3XAY/smartlamp/Documentation Pictures/PXL_20260616_120528385.jpg

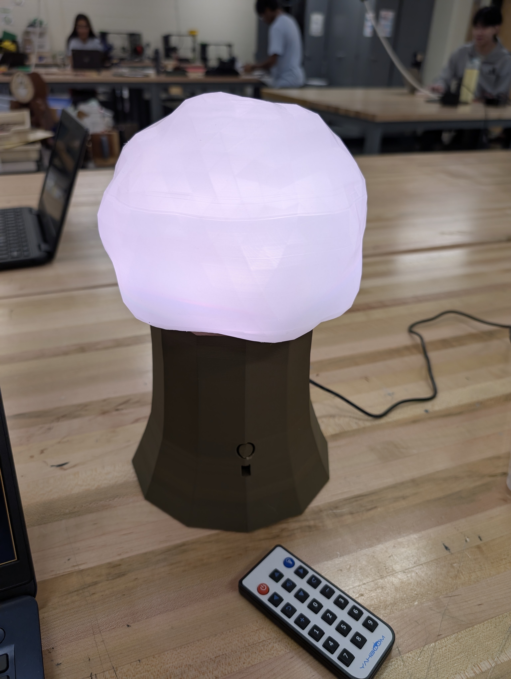
Documentation Pictures/PXL_20260616_120528385.jpg
