3XAY/smartlamp/Documentation Pictures/PXL_20260608_141349632.jpg

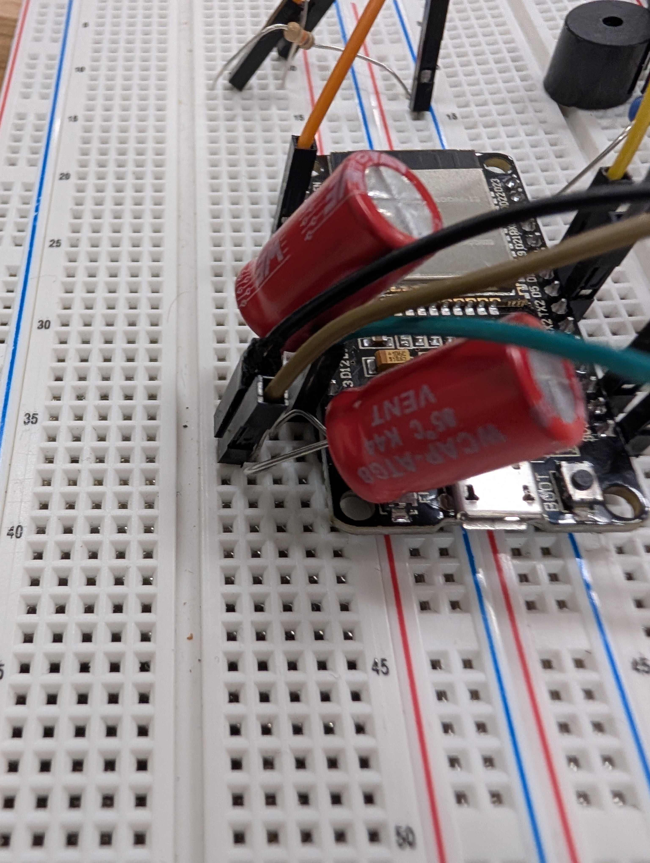
Documentation Pictures/PXL_20260608_141349632.jpg
