3XAY/smartlamp/Lamp Portfolio.pdf

# Lamp Portfolio

## Ayan Bindal

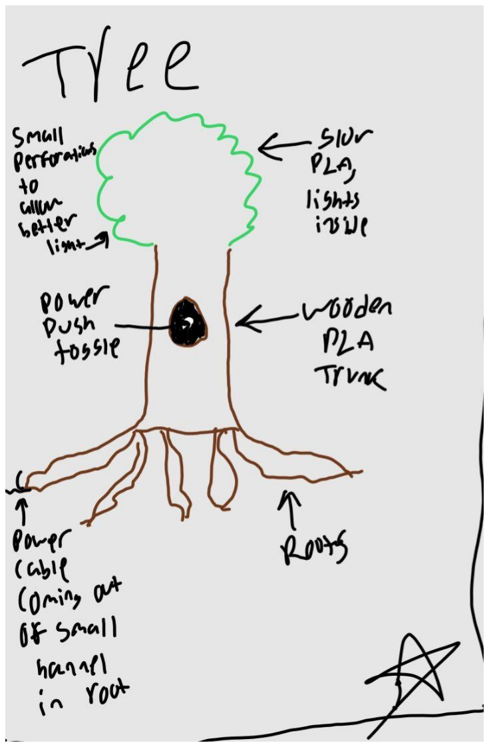
[picture p3: figure]

## Idea #1 - Tree

## Idea #2 - Mushroom

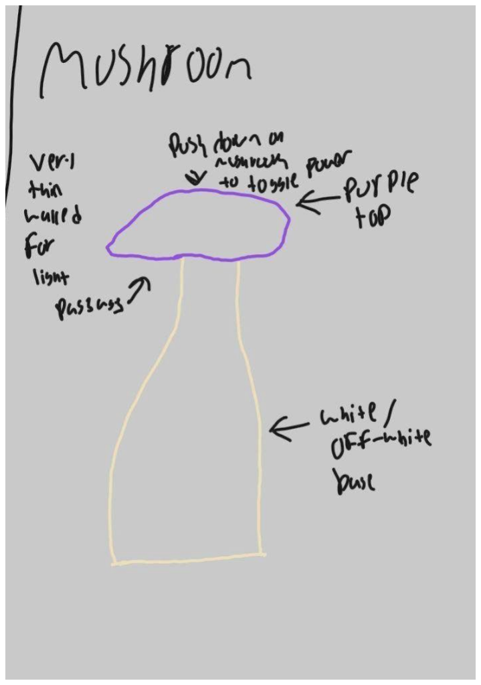
[picture p4: figure]

## Idea #3 - Abstract

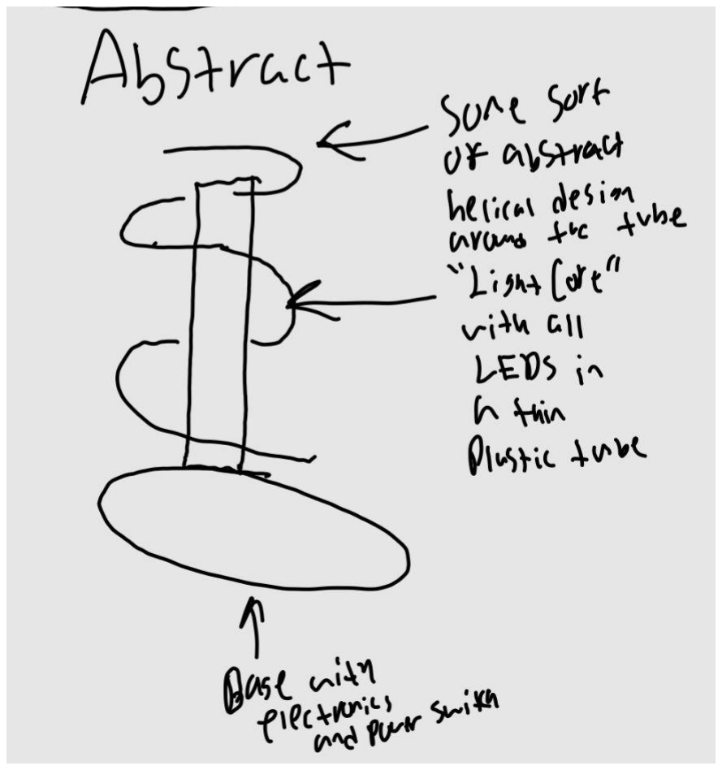
[picture p5: figure]

## Goals

A realistic tree lamp that when turned off, glows in the dark and becomes a decorative piece, but when on becomes a source of bright, natural light.

## Why?

I thought that a lamp that doesn’t look like a lamp at first glance would be really cool, and the glow-in-the-dark feature sounds really nice.

## Inspiration Pictures

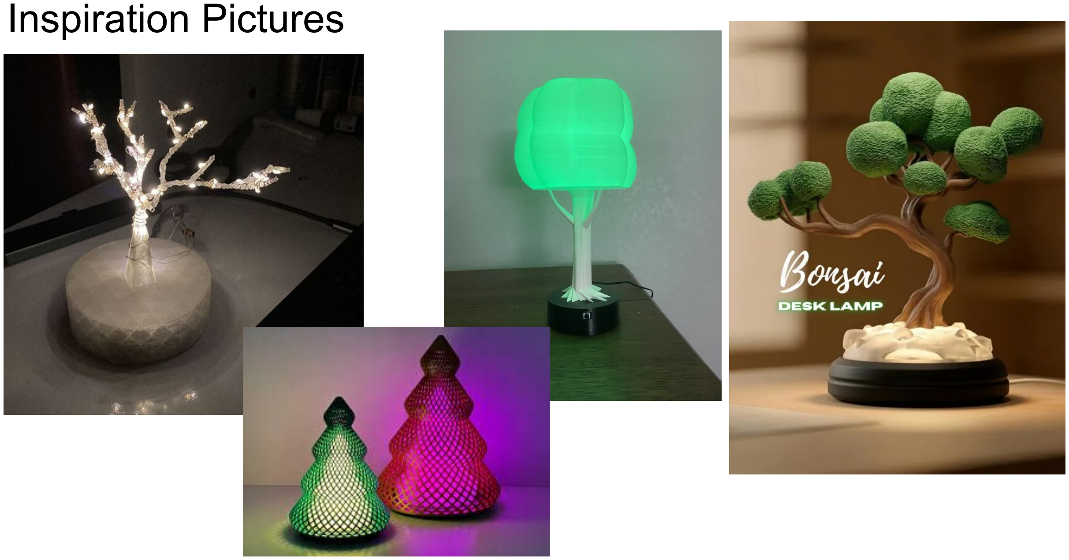
[picture p6: page 7]

## Materials to be used

- Wood PLA for trunk
- Glow PLA for leaves
- Push toggle switch for power
- Arduino UNO
- Neopixel strip (thicker one with white flex PCB) - 3ft length
- DC to screw terminal block
- DC power adapter (5V/2A)

## Circuit

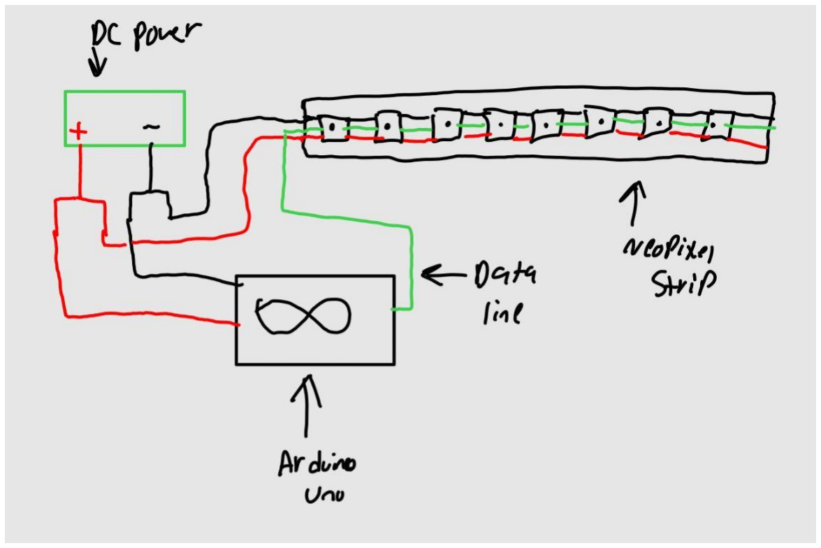
[picture p7: figure]

## Initial Model (Internals)

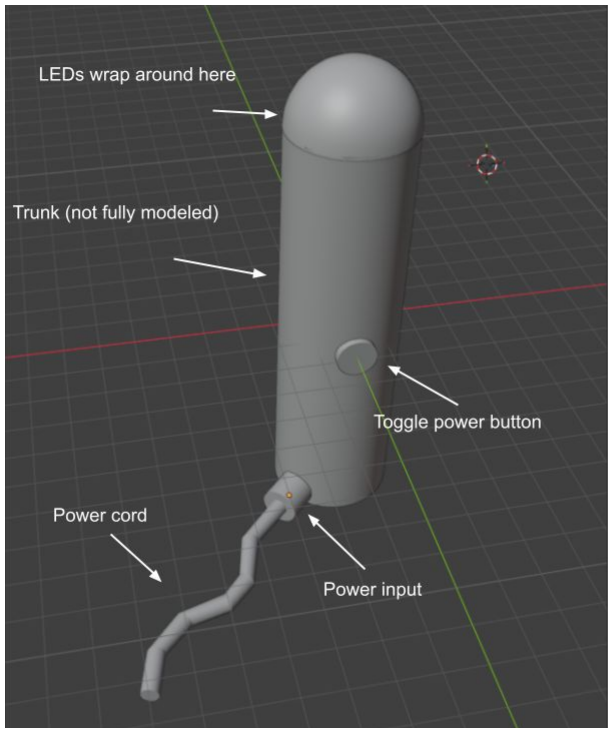
[picture p8: figure]

## Design Update

- Added IR receiver (Enables remote control)
- Switched to ESP32 (Allows for accurate time (sunset/sunrise timers) and wireless control)
- Switched to swappable external shell (the visible tree part) (Allows for designs to be easily swapped by swapping the shell rather than transplanting electronics)
- Added various features through WebUI (Timer, night light, wireless updating)
- Added a buzzer (To beep the IP address of the lamp & general sound effects)
- Added power-loss recovery & brown-out protection (Remembers lamp state by saving it to flash before capacitors drain)

## Schematic (updated)

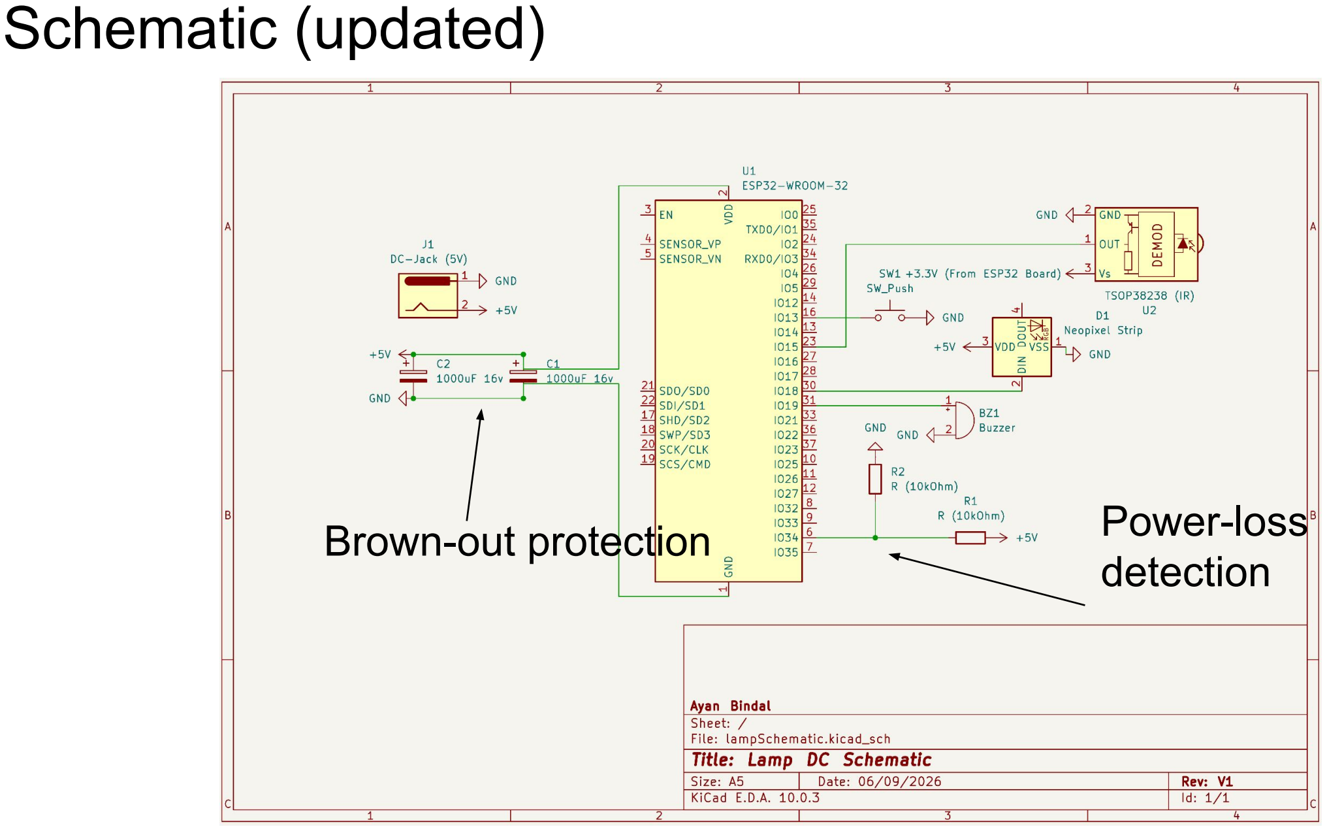
[picture p9: page 12]

Brown-out protection | Power-loss detection

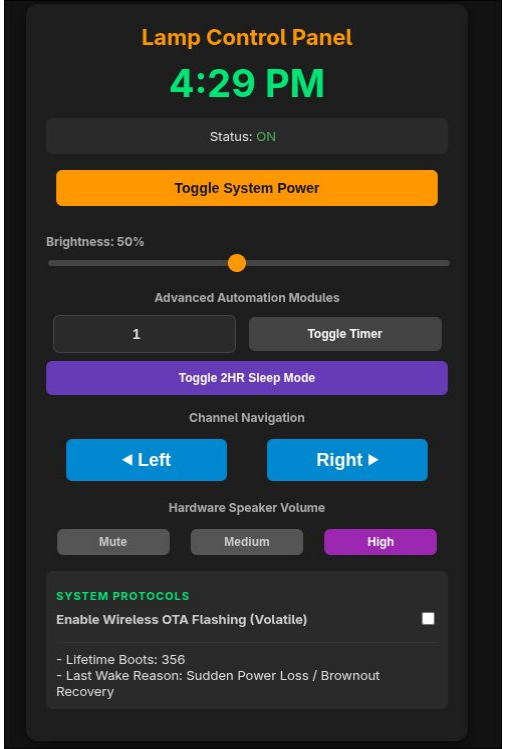
[picture p10: figure]

## WebUI Testing

## Breadboard testing

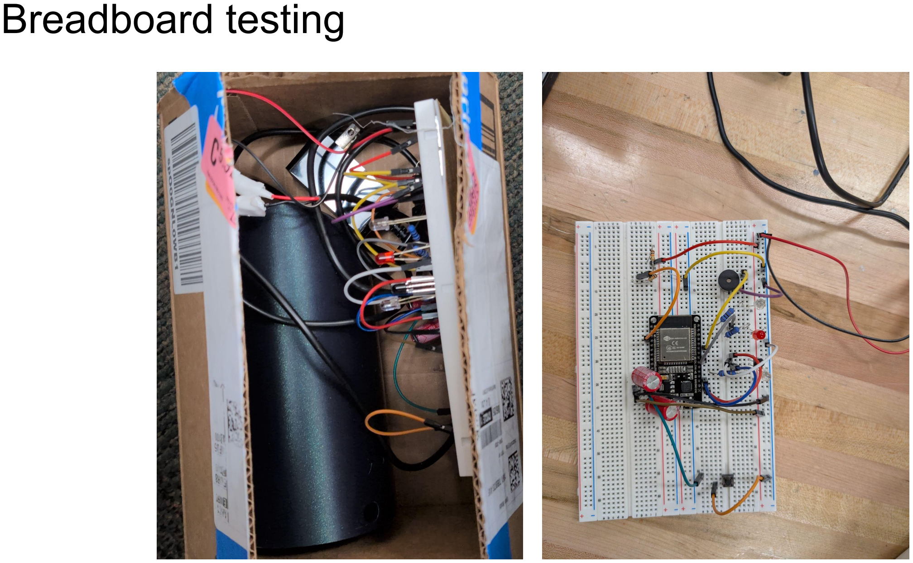
[picture p11: page 14]

## Internal 3D Model & Print

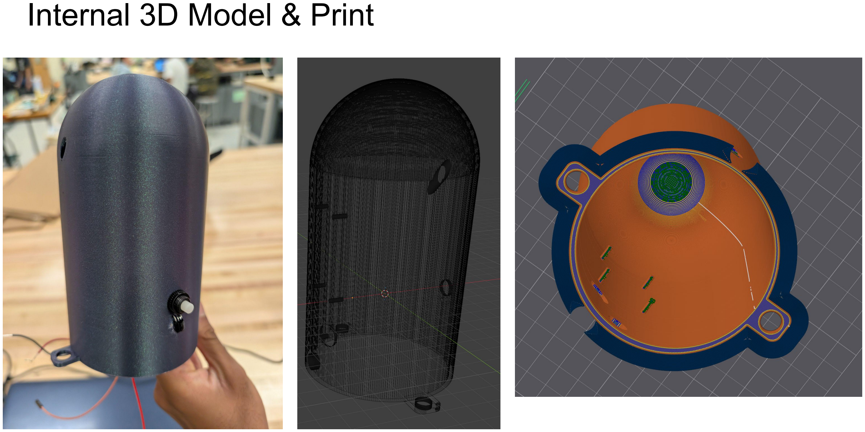
[picture p12: page 15]

## Troubleshooting

- Testing & removal of ambient light sensing
- Lamp would likely interfere with itself, creating an infinite feedback loop
- Finding IR frequency & pins
- I had multiple types of IR receivers, finding the correct ones and the pinout was challenging without a part number
- Tweaking power-loss recovery
- Flash wear leveling
■ Makes sure to only write to the flash when the lamp loses power, helps save on flash write cycles on the ESP32, improves longevity

## Updated BOM

- Wood PLA for trunk
- Glow PLA for leaves
- Push toggle switch for power
- ESP32 (Rather than the Arduino UNO for WiFi & size)
- Neopixel strip (thicker one with white flex PCB) - 3ft length
- DC to screw terminal block
- DC power adapter (5V/2A)
- IR Receiver (For remote control)
- Buzzer (For system status updates & sound effects)

## Final Assembled Circuit

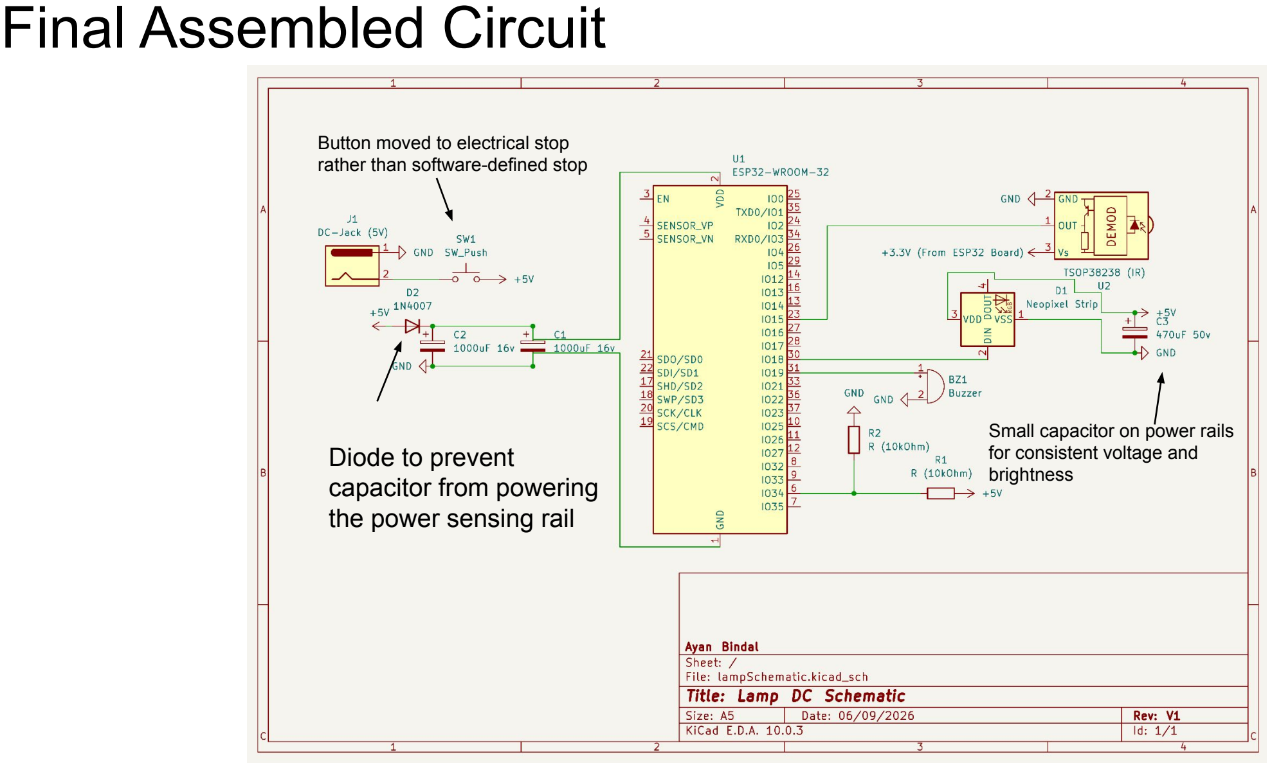
[picture p13: page 18]

Diode to prevent
capacitor from powering
the power sensing rail

Small capacitor on power rails for consistent voltage and brightness

Button moved to electrical stop rather than software-defined stop

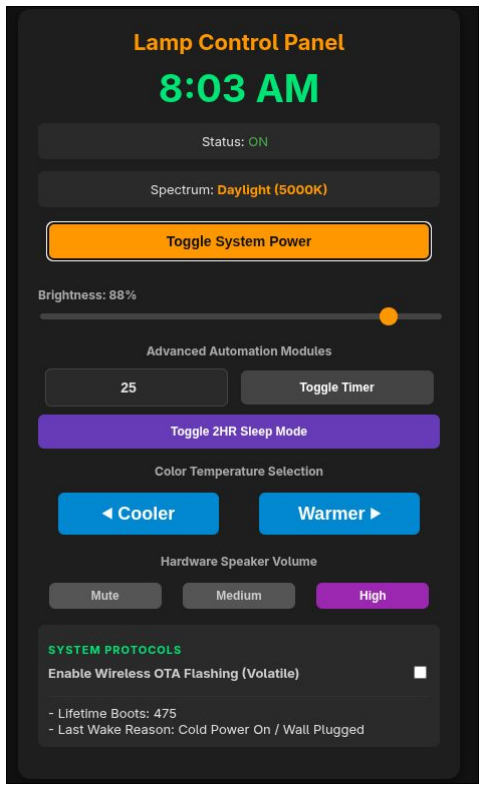
[picture p14: figure]

## Final WebUI

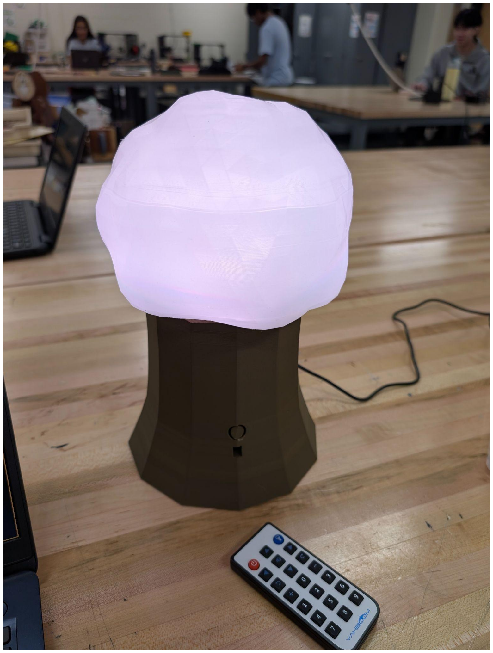
[picture p15: figure]

## Final Result

## What Worked Well

- Using Glow-in-the-dark PLA for the lampshade
- Using the ESP32 microcontroller
- Implementing power-loss recovery
- Adding a buzzer for lamp status

## Biggest Challenges Faced

- Designing and assembling the actual lamp structure
- 3D printer size limitations (180x180x180mm)
- Tolerances
- Material strength
- Properly sealing the bottom of the lamp
- Failed screw attempts (poor material & print orientation, shallow threads in trunk)

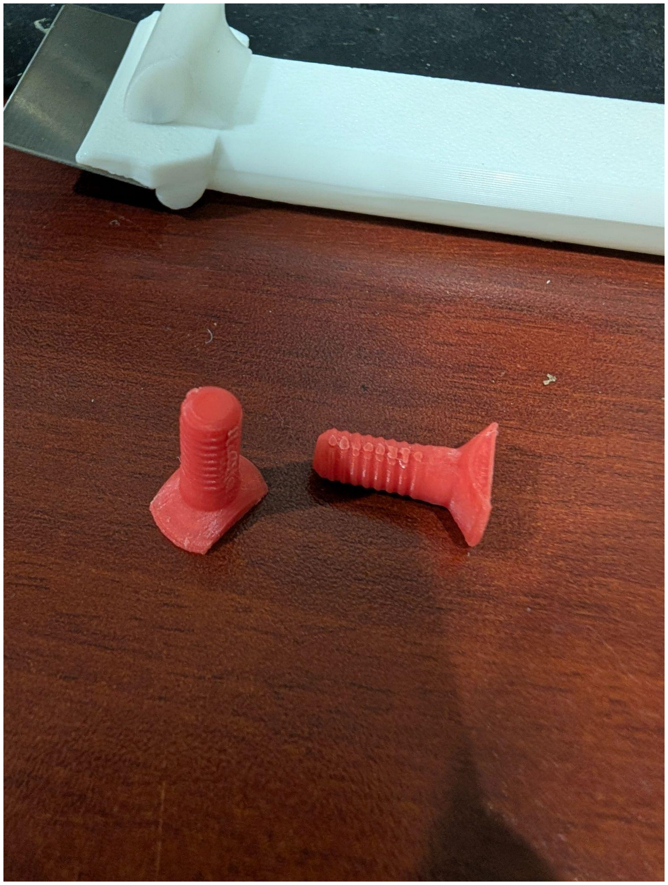
[picture p16: figure]

## How Problems Were Solved

- Large tolerances were implemented
- This led to large gaps, but most were not visible during normal operation
- Metal screws & a mix of metal & 3D printer washers were used to seal the bottom rather than 3D printed screws
- Needed to put brass heat-set inserts into shallow threads of the trunk to make metal screws work
- Lots of iterations & troubleshooting for any and all other problems
- Ex. Button sizing & placement, bottom cap tolerances, 3D printing supports tuning

## What I Learned About Electronics

I learned that you should always make sure to plan ahead, especially keeping wires in mind rather than just fitting parts into an enclosure. Since I typically work with PCBs, this is less of a concern, but is made much more significant with wires going everywhere.

## What I Would Improve

- Remove (or partially remove) the magnets embedded in the lampshade & trunk
- Do not significantly increase the grip between the two objects
- Design the entire lamp as one piece rather than having an electronics enclosure with a tree shell
- Makes a lot more room to work with, simpler overall design, less tolerances to worry about, better power, IR, and button placement
- Solder connections between LED strips
- Can be somewhat fragile
