3XAY/smartlamp/Documentation Pictures/09b6a4a0-b3d0-481d-bf98-f53a0fa5551f.jpg

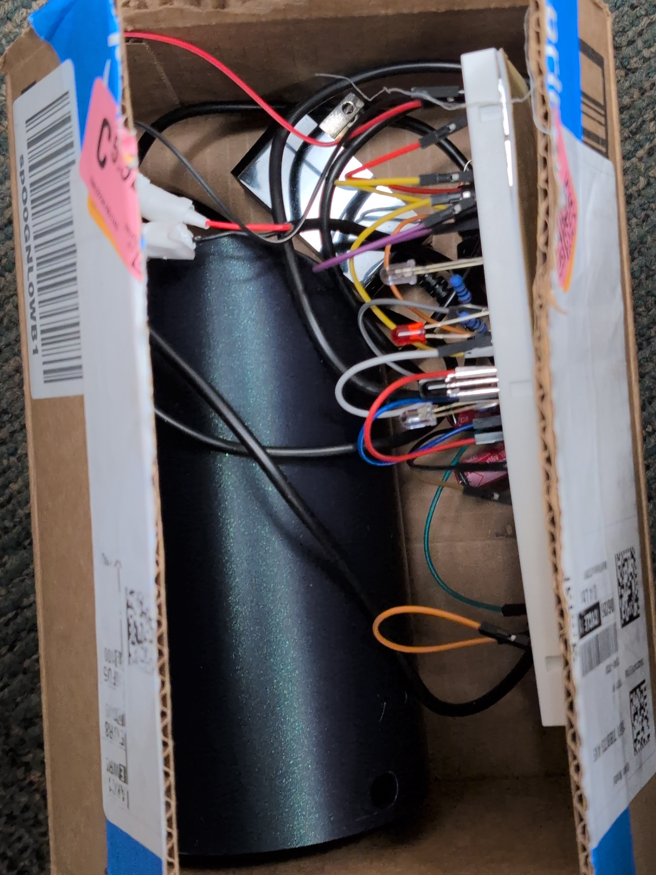
Documentation Pictures/09b6a4a0-b3d0-481d-bf98-f53a0fa5551f.jpg
