3XAY/smartlamp/Documentation Pictures/PXL_20260608_141345404.jpg

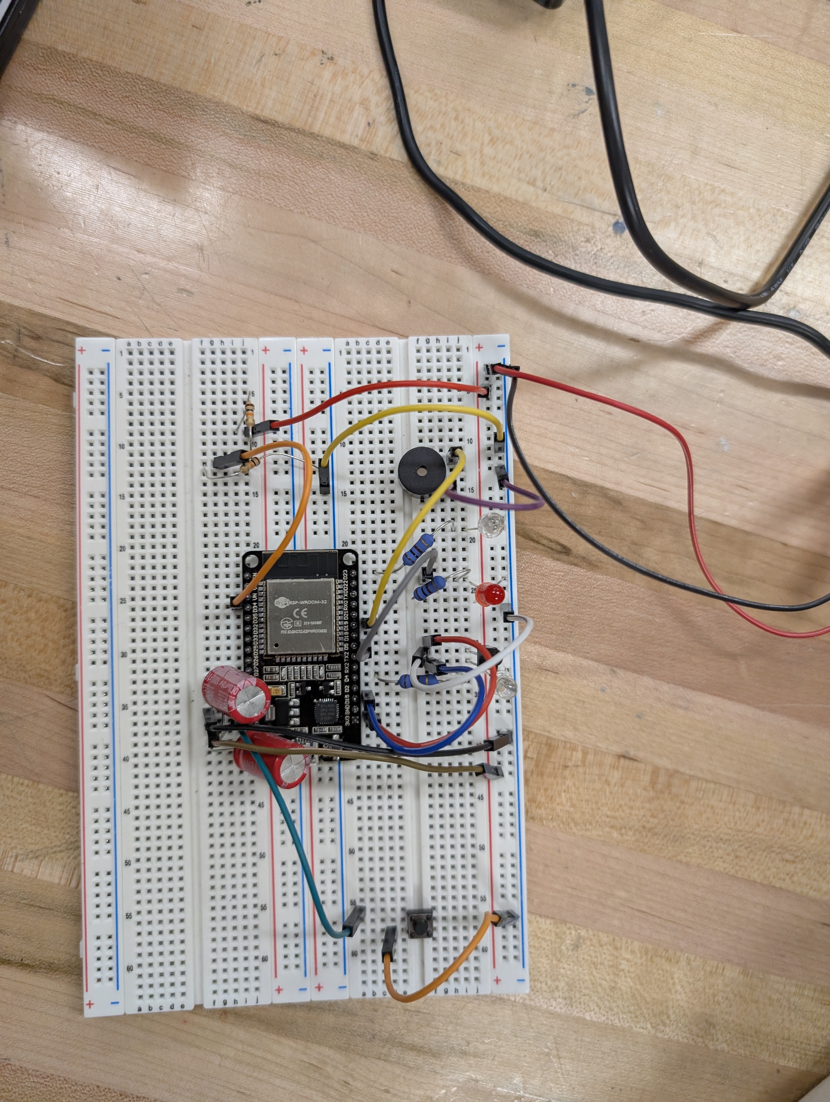
Documentation Pictures/PXL_20260608_141345404.jpg
