3XAY/smartlamp/Documentation Pictures/PXL_20260608_141352063.jpg

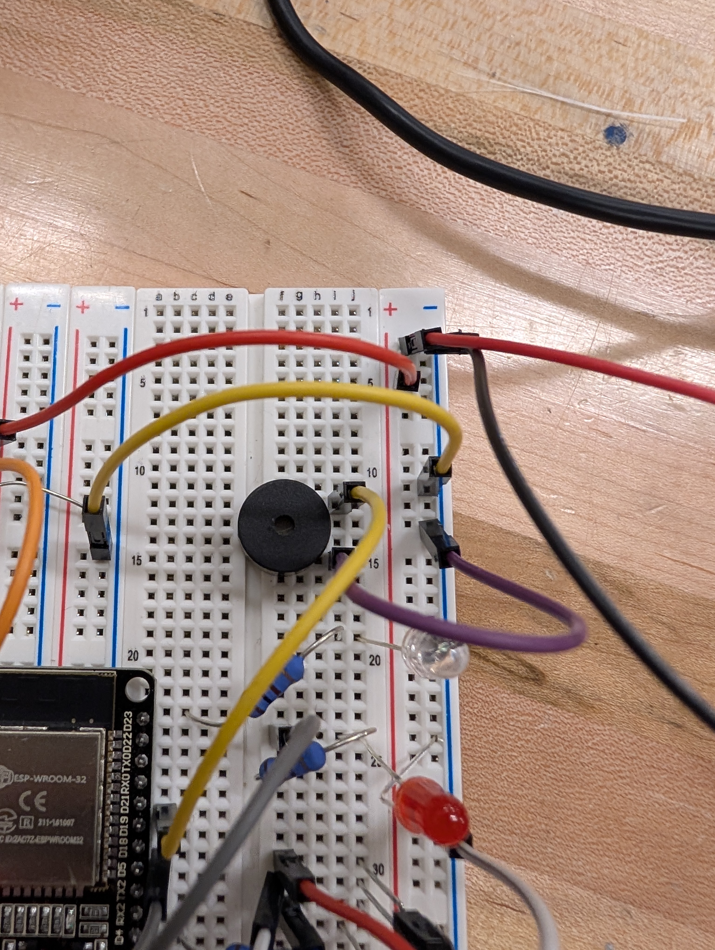
Documentation Pictures/PXL_20260608_141352063.jpg
