3XAY/smartlamp/Documentation Pictures/PXL_20260608_141354558.MP.jpg

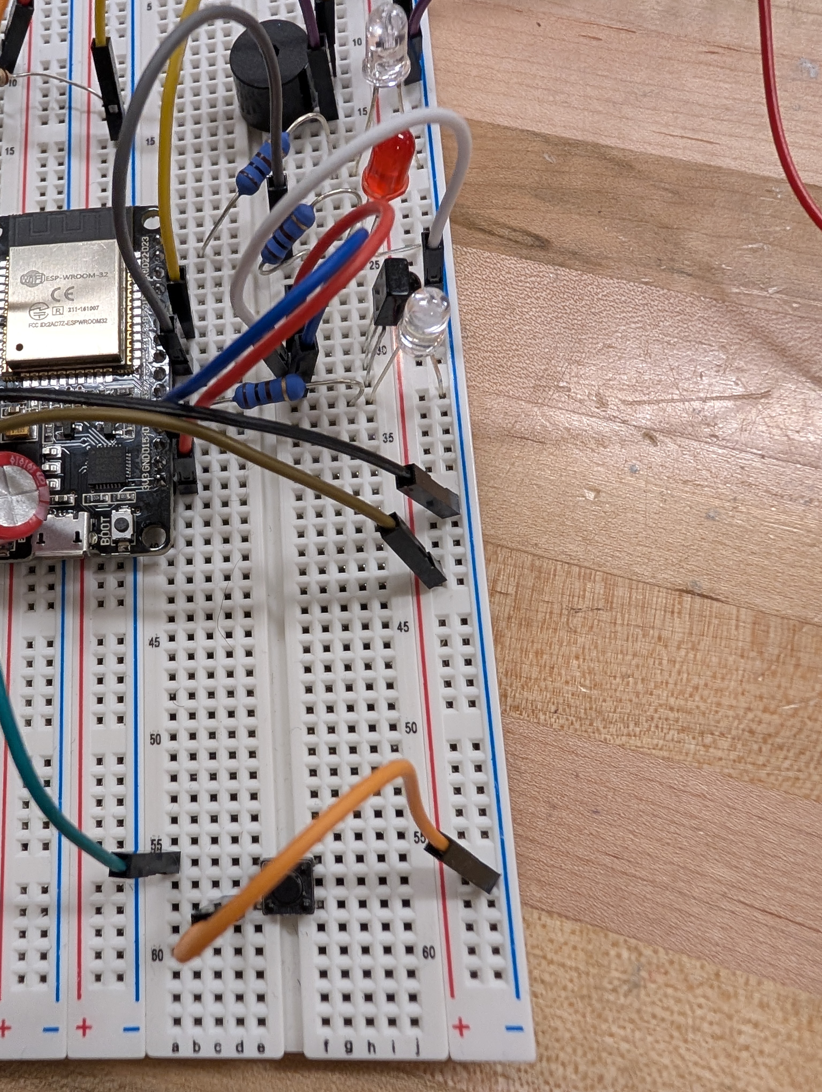
Documentation Pictures/PXL_20260608_141354558.MP.jpg
