3XAY/smartlamp/Documentation Pictures/PXL_20260611_124734128.MP.jpg

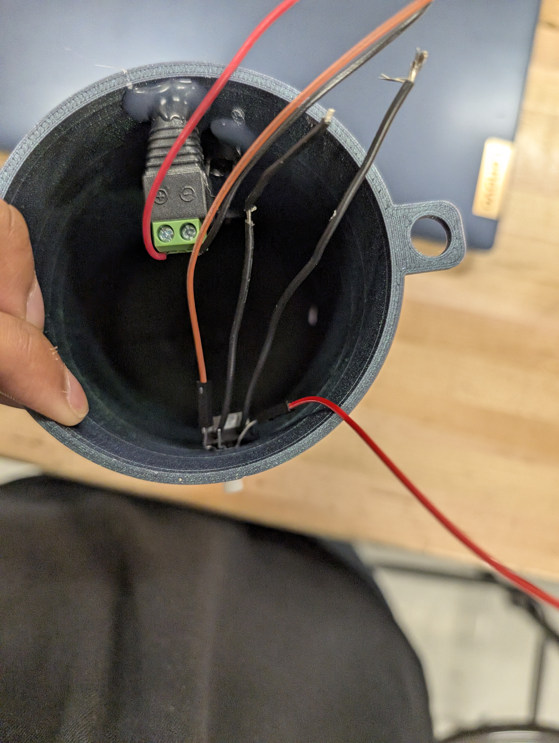
Documentation Pictures/PXL_20260611_124734128.MP.jpg
