3XAY/smartlamp/Documentation Pictures/PXL_20260611_124740239.jpg

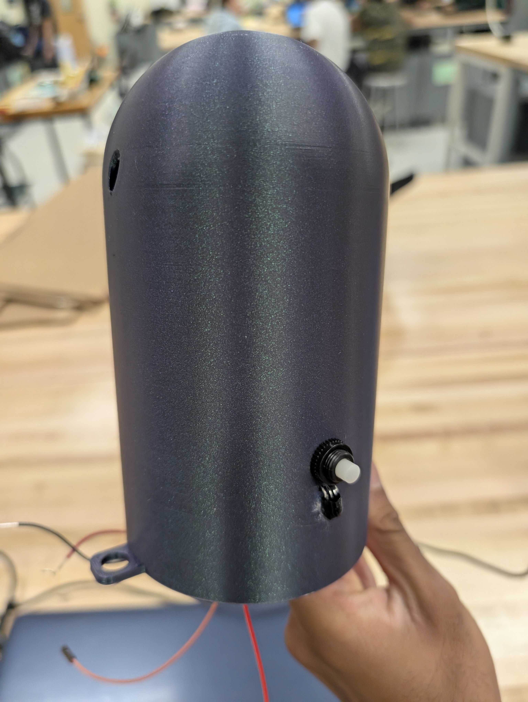
Documentation Pictures/PXL_20260611_124740239.jpg
