3XAY/smartlamp/Documentation Pictures/Screenshot 2026-06-10 063435.png

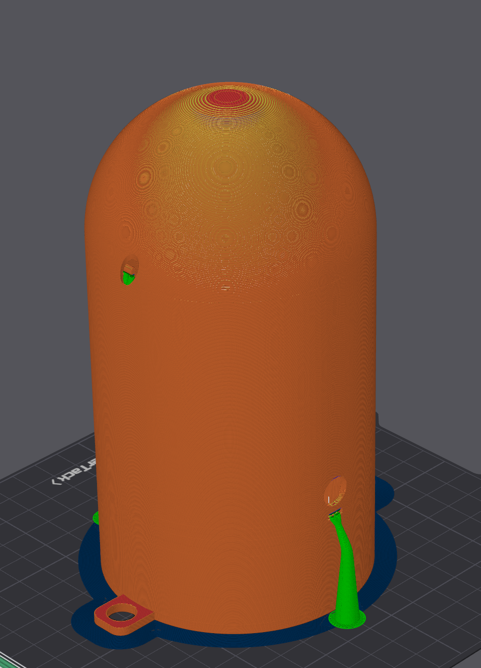
Documentation Pictures/Screenshot 2026-06-10 063435.png
