3XAY/smartlamp/Documentation Pictures/Screenshot 2026-06-10 063632.png

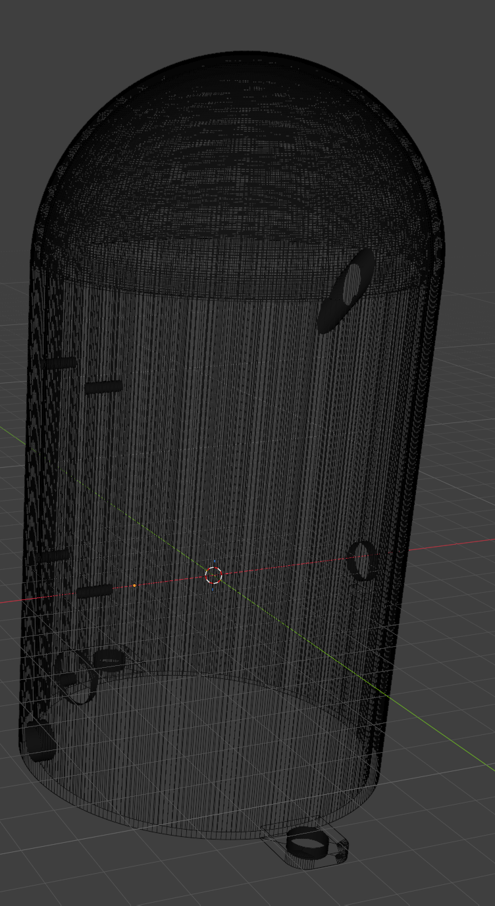
Documentation Pictures/Screenshot 2026-06-10 063632.png
