3XAY/smartlamp/(list of files, cad)

Other CAD files:
LampCAD.blend
