3XAY/smartlamp/Schematic/lampSchematic.pdf

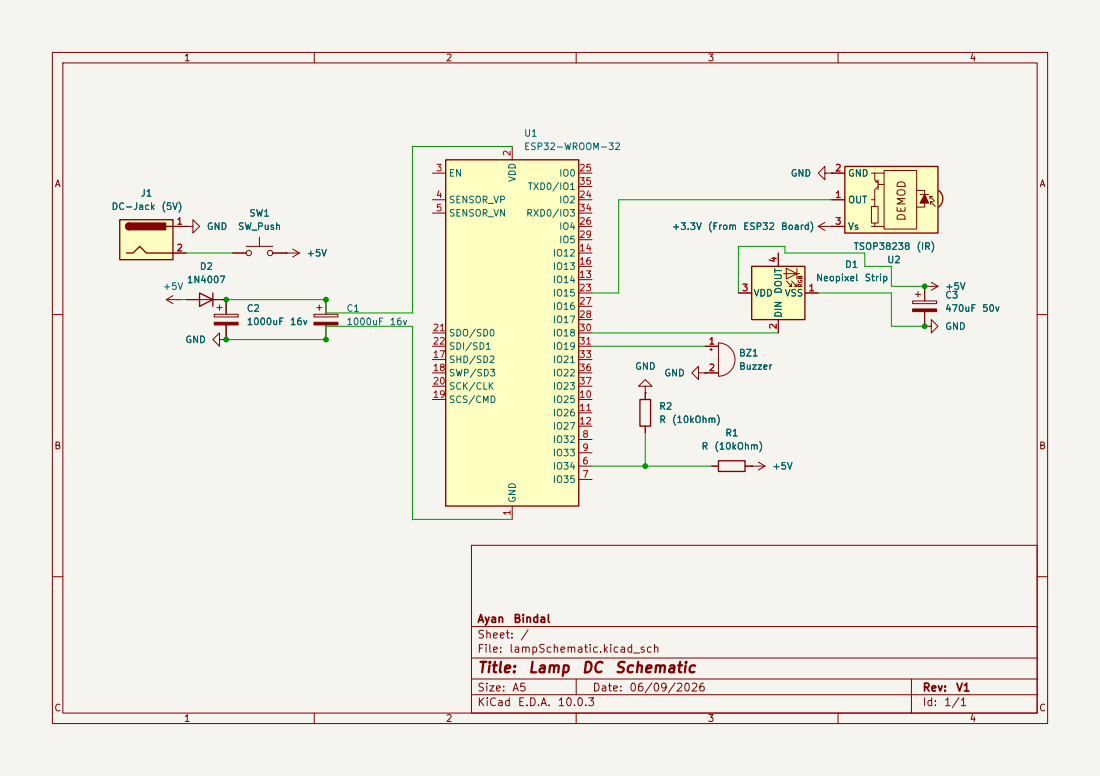
[picture p31: page 1]

Sheet: /
File: lampSchematic.kicad_sch
Title: Lamp DC Schematic

Size: A5 | Rev: V1 | C Date: 06/09/2026
KiCad E.D.A. 10.0.3 | Id: 1/1
