3XAY/smartlamp/Schematic/lampSchematic.kicad_sch

## KiCad design Schematic/lampSchematic.kicad_sch (2026-11-01)

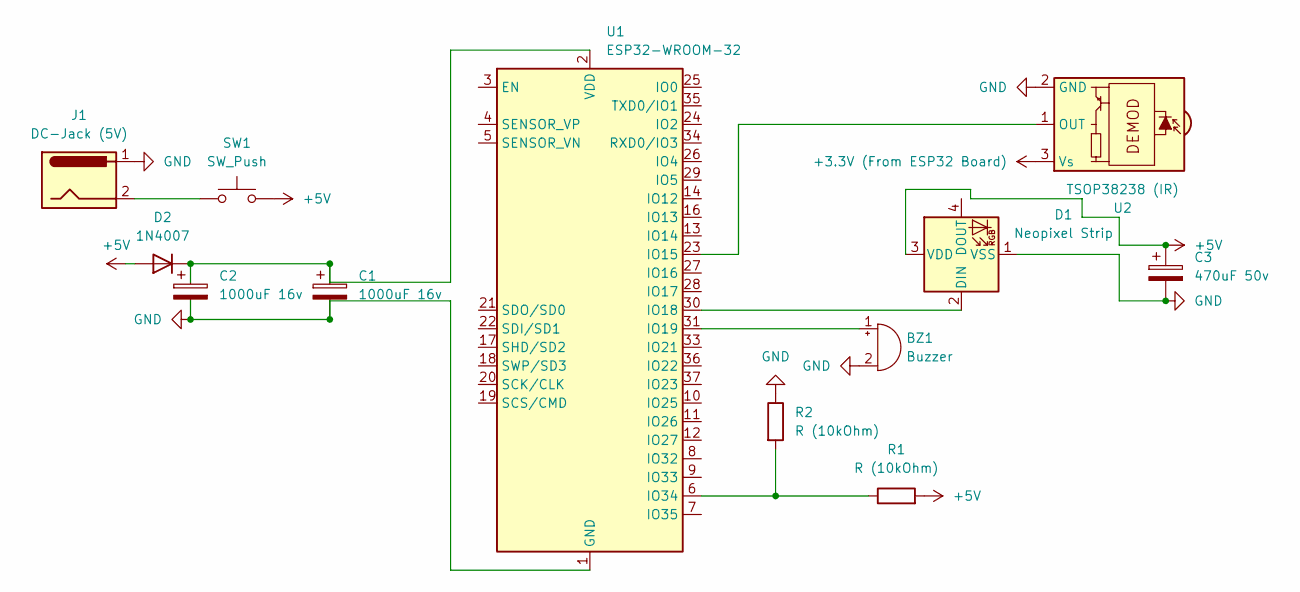
[picture p32: schematic lampSchematic.kicad_sch]

Parts:
BZ1: Buzzer
C1, C2: 1000uF 16v
C3: 470uF 50v
D1: Neopixel Strip; LED_SK6812_PLCC4_5.0x5.0mm_P3.2mm
D2: 1N4007; D_DO-41_SOD81_P10.16mm_Horizontal
J1: DC-Jack (5V)
R1, R2: R (10kOhm)
SW1: SW_Push
U1: ESP32-WROOM-32
U2: TSOP38238 (IR); Vishay_MINICAST-3Pin

Connections:
+3.3V (From ESP32 Board): U2.3 (Vs)
+5V: C3.1, D1.3 (VDD), D2.2 (A), R1.2, SW1.2
GND: BZ1.2 (-), C1.2, C2.2, C3.2, D1.1 (VSS), J1.1, R2.1, U1.1 (GND), U1.15 (GND), U1.38 (GND), U1.39 (GND), U2.2 (GND)
unnamed: BZ1.1 (+), U1.31 (IO19)
unnamed: C1.1, C2.1, D2.1 (K), U1.2 (VDD)
unnamed: D1.2 (DIN), U1.30 (IO18)
unnamed: J1.2, SW1.1
unnamed: R1.1, R2.2, U1.6 (IO34)
unnamed: U1.23 (IO15), U2.1 (OUT)
